EthanHNguyen/cataclysm/README.md

# cataclysm
A repository for the Purdue Milestones - Design a Smartwatch course.
