EthanHNguyen/cataclysm/(commit log)

2020-06-04 Added 3D, Hardware, and PPG-module
    [cataclysm-AUX1.brd, cataclysm-AUX1.sch, cataclysm-AUX2-BOM.xlsx, cataclysm-AUX2.brd, cataclysm-AUX2.sch, cataclysm-BOTTOM-BOM.xlsx, cataclysm-BOTTOM.brd, cataclysm-BOTTOM.sch]
2020-06-04 Added missing BOM
    [cataclysm-AUX1-BOM.xlsx]
2020-06-04 Added OLED display, power management section, bluetooth microcontroller, and buttons
    [cataclysm-TOP.brd, cataclysm-TOP.sch]
2020-06-11 complete top circuit schematic
    [cataclysm-TOP.brd, cataclysm-TOP.sch]
2020-06-12 Finished top and bottom schematic
    [cataclysm-BOTTOM.brd, cataclysm-BOTTOM.sch, cataclysm-TOP.brd, cataclysm-TOP.sch]
2020-06-15 Routed bottom board
    [cataclysm-BOTTOM.brd, cataclysm-BOTTOM.sch]
2020-06-30 Updated top board
    [cataclysm-TOP.brd, cataclysm-TOP.sch]
2020-06-30 Arduino OOP
2020-07-02 Almost finished with take 8
    [cataclysm-BOTTOM.brd, cataclysm-BOTTOM.sch, cataclysm-TOP.brd, cataclysm-TOP.sch]
2020-07-02 Take 7 Finished;
    [cataclysm-TOP.brd, cataclysm-TOP.sch]
2020-07-02 Take 7 Done w/ no airwire
    [cataclysm-TOP.brd]
2020-07-03 Finished take 8!
    [cataclysm-BOTTOM.brd, cataclysm-BOTTOM.sch, cataclysm-TOP.brd, cataclysm-TOP.sch]
2020-07-05 Added PPG module and BOM
    [cataclysm-BOTTOM-BOM.xlsx, cataclysm-PPG-MODULE.brd, cataclysm-PPG-MODULE.sch, cataclysm-PPG-Module-BOM.xlsx]
2020-07-23 Test firmware with LCD and timer
2020-08-04 Fixed connection b/w top and bottom boards
    [cataclysm-BOTTOM.brd, cataclysm-BOTTOM.sch, cataclysm-TOP.brd]
2020-08-06 generated Gerbers
